TWCCarlson/MicroMouse/MAZE/ASSEM-EXAMPLE.SLDASM

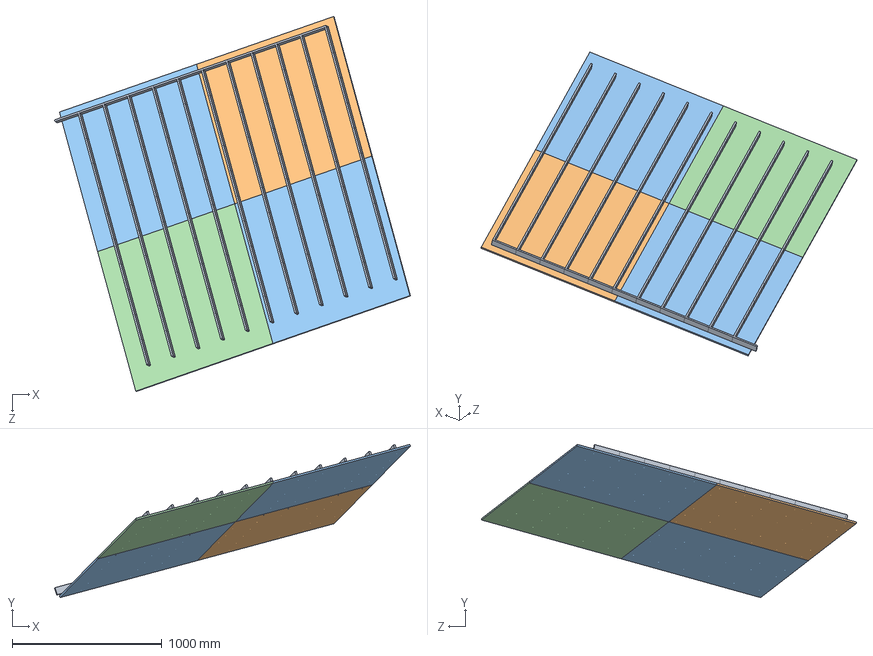
[picture p1: CAD file, 2020-10-15]
MAZE/ASSEM-EXAMPLE.SLDASM
2376.5 x 1023.0 x 2503.2 mm
WALL x 121
BASE-TYPE-A
BASE-TYPE-B x 2
BASE-TYPE-C
