TWCCarlson/MicroMouse/MOUSE/Assem3.SLDASM

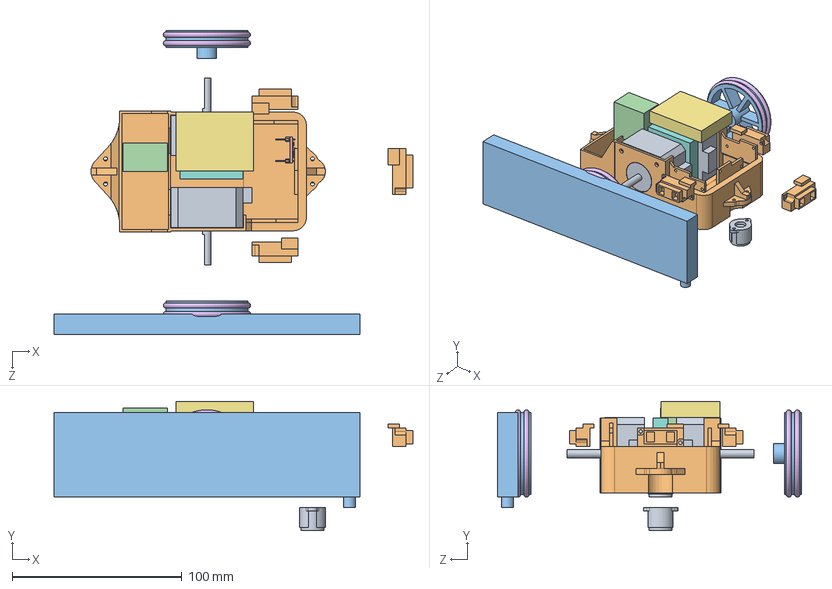
[picture p2: CAD file, 2020-12-29]
MOUSE/Assem3.SLDASM
211.3 x 76.0 x 179.0 mm
NEMA17 x 2
SharpIRSensor x 3
WheelRim2 x 2
O-rin x 4
LiPoBattery
BallCaster x 2
Chassis2
