TWCCarlson/MicroMouse/MOUSE/Assem2.SLDASM

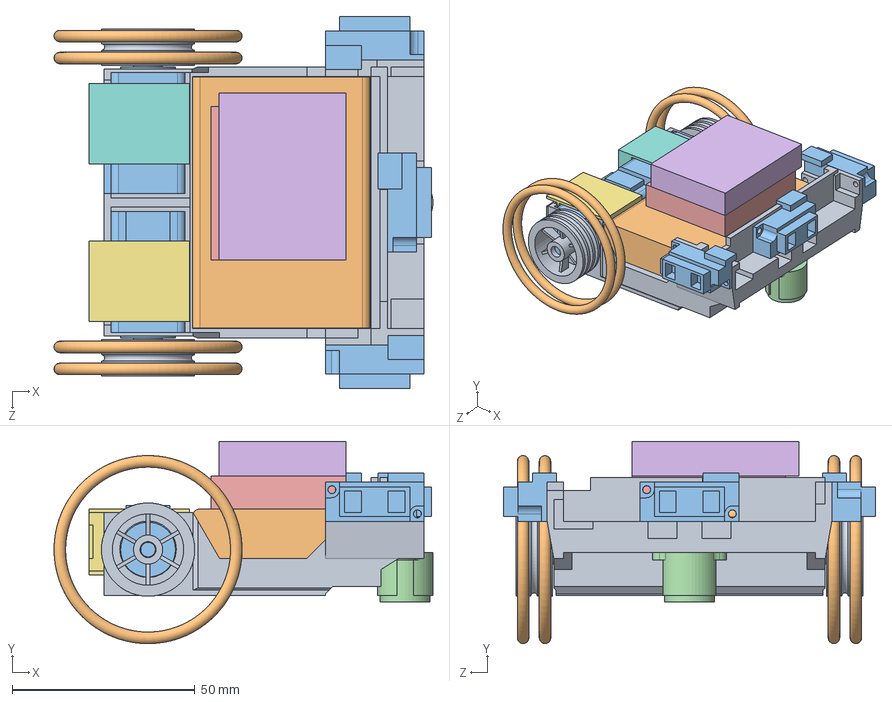
[picture p3: CAD file, 2020-11-01]
MOUSE/Assem2.SLDASM
103.6 x 55.3 x 101.8 mm
ChassisRemake
AABatteryPack
N8StepperMotor x 2
BallCaster
LiPoBattery
FeatherMiniBoard
N8DriverShelf
N8DriverShelfMir
WheelRim x 2
O-rin x 4
SharpIRSensor x 3
