TWCCarlson/MicroMouse/MOUSE/Assem1.SLDASM

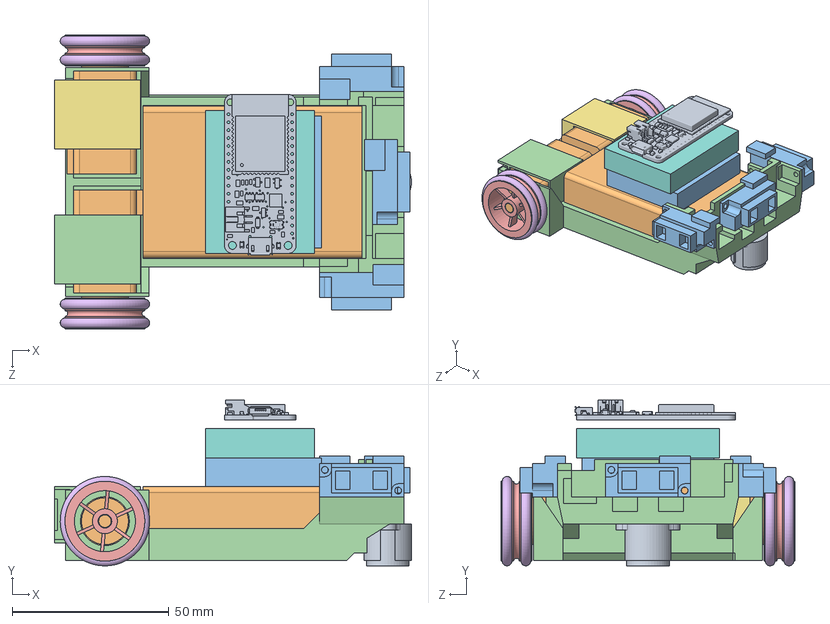
[picture p4: CAD file, 2020-10-16]
MOUSE/Assem1.SLDASM
114.0 x 53.0 x 94.0 mm
BallCaster
N8StepperMotor x 2
SharpIRSensor x 3
N8DriverShelf
WheelRim x 2
O-rin x 4
N8DriverShelfMir
FeatherMiniBoard
3405 Adafruit HUZZAH32 ESP32 Feather2
AABatteryPack
LiPoBattery
ChassisBreak
