TWCCarlson/MicroMouse/MOUSE/Calibration/IRCalibStand.SLDPRT

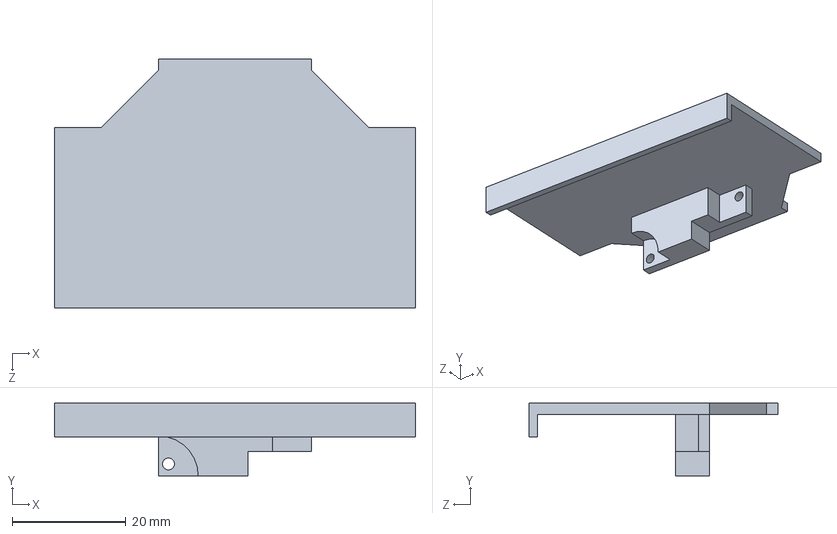
[picture p5: CAD file, 2020-11-25]
MOUSE/Calibration/IRCalibStand.SLDPRT
63.5 x 12.8 x 43.8 mm
