TWCCarlson/MicroMouse/MOUSE/Chassis2.sldprt

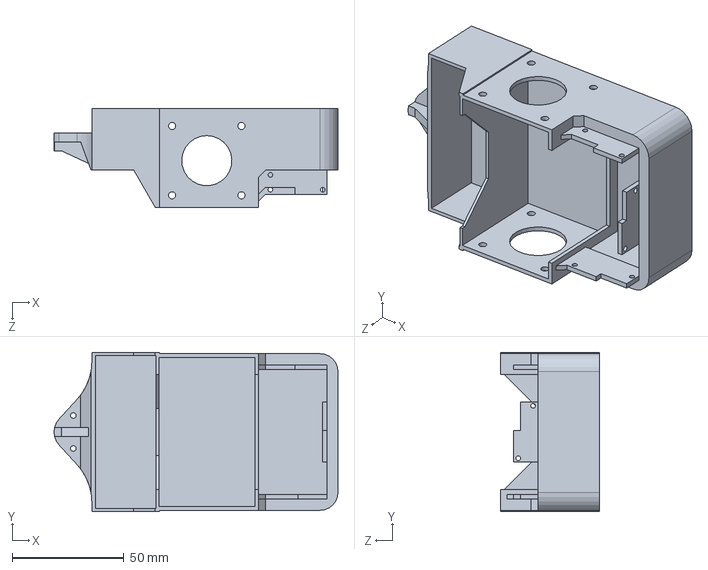
[picture p6: CAD file, 2020-12-29]
MOUSE/Chassis2.sldprt
126.9 x 71.2 x 44.1 mm
