TWCCarlson/MicroMouse/MAZE/BASE-TYPE-B.SLDPRT

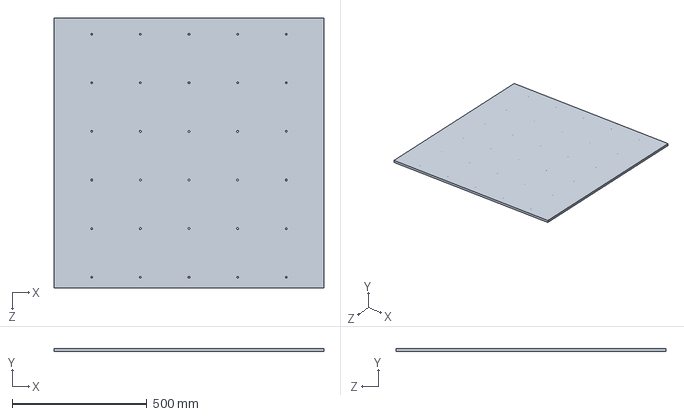
[picture p7: CAD file, 2020-10-15]
MAZE/BASE-TYPE-B.SLDPRT
1000.0 x 12.0 x 1000.0 mm
