TWCCarlson/MicroMouse/MOUSE/IRSensorVertMount.SLDPRT

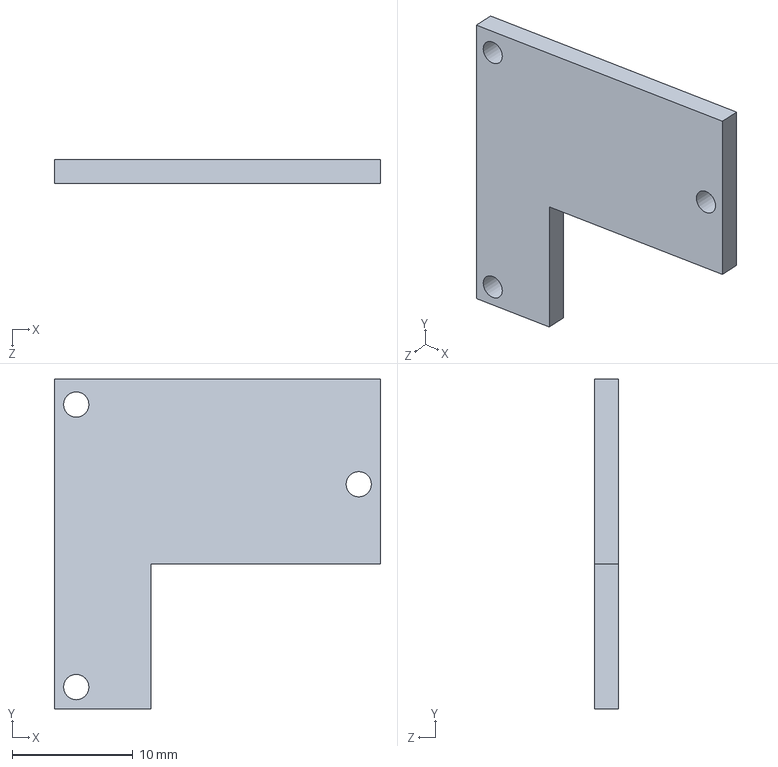
[picture p8: CAD file, 2020-12-11]
MOUSE/IRSensorVertMount.SLDPRT
27.0 x 27.3 x 2.00 mm
