TWCCarlson/MicroMouse/MAZE/WALL.SLDPRT

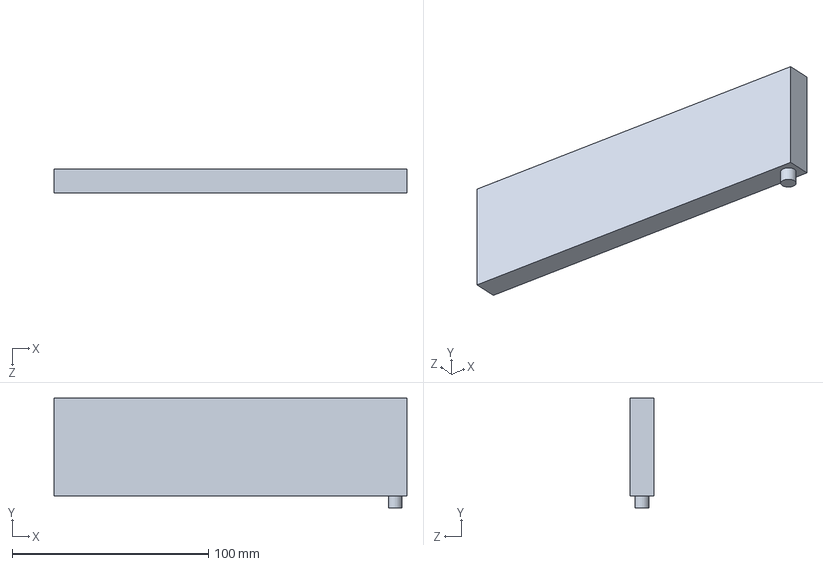
[picture p9: CAD file, 2020-10-15]
MAZE/WALL.SLDPRT
180.0 x 56.0 x 12.0 mm
