TWCCarlson/MicroMouse/MOUSE/IRSensorVertMountRight.SLDPRT

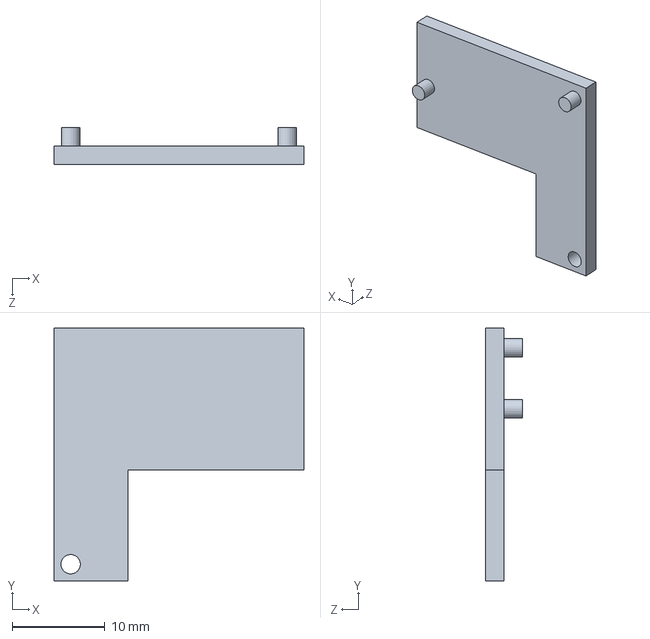
[picture p10: CAD file, 2020-12-11]
MOUSE/IRSensorVertMountRight.SLDPRT
27.0 x 27.3 x 4.00 mm
