TWCCarlson/MicroMouse/MOUSE/IRSensorVertMountLeft.SLDPRT

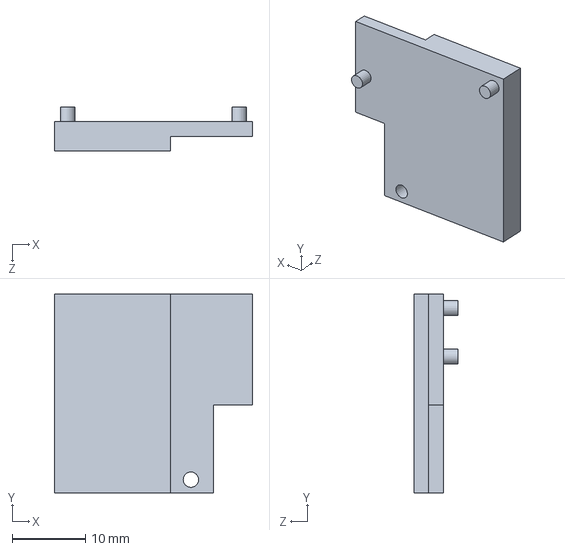
[picture p11: CAD file, 2020-12-11]
MOUSE/IRSensorVertMountLeft.SLDPRT
27.0 x 27.1 x 6.00 mm
