TWCCarlson/MicroMouse/MOUSE/WheelRim2.SLDPRT

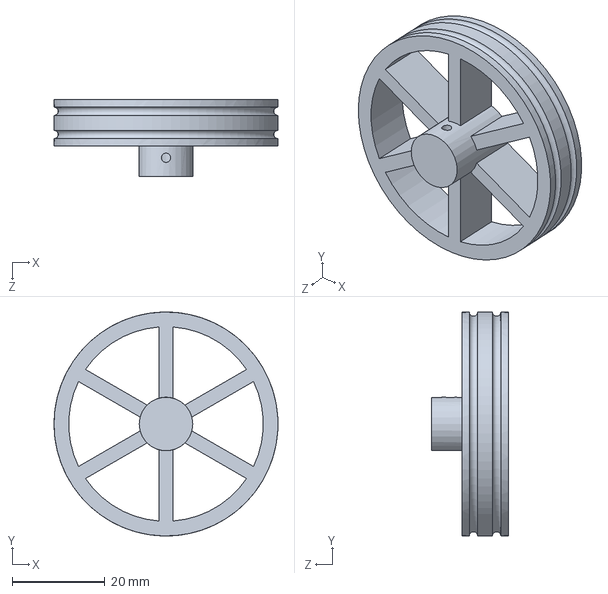
[picture p12: CAD file, 2020-11-30]
MOUSE/WheelRim2.SLDPRT
48.3 x 48.2 x 16.5 mm
