TWCCarlson/MicroMouse/MOUSE/N8DriverShelf1.SLDPRT

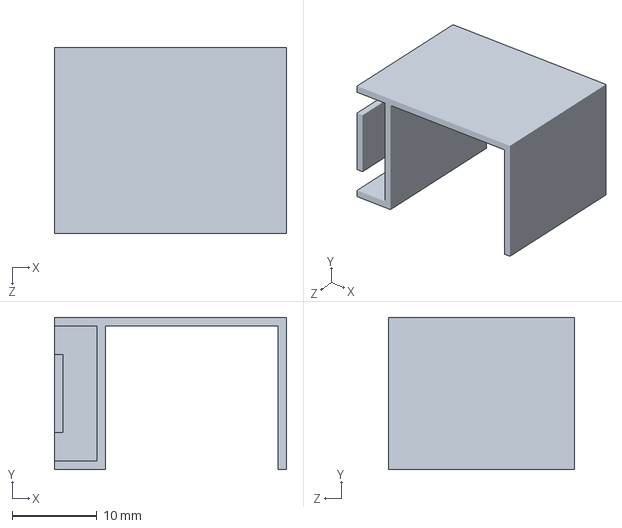
[picture p13: CAD file, 2020-11-01]
MOUSE/N8DriverShelf1.SLDPRT
27.4 x 18.0 x 22.0 mm
