TWCCarlson/MicroMouse/MOUSE/WheelRim.SLDPRT

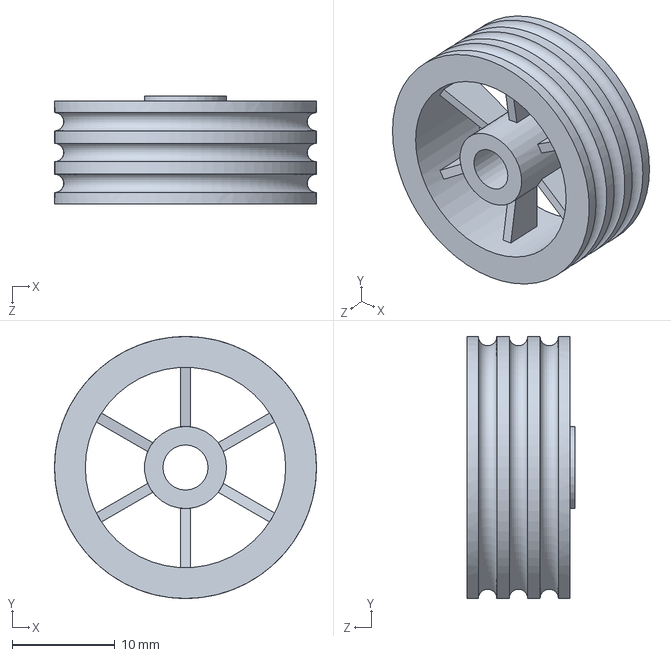
[picture p14: CAD file, 2020-11-01]
MOUSE/WheelRim.SLDPRT
25.5 x 25.5 x 10.5 mm
