TWCCarlson/MicroMouse/MOUSE/9vBattery.SLDPRT

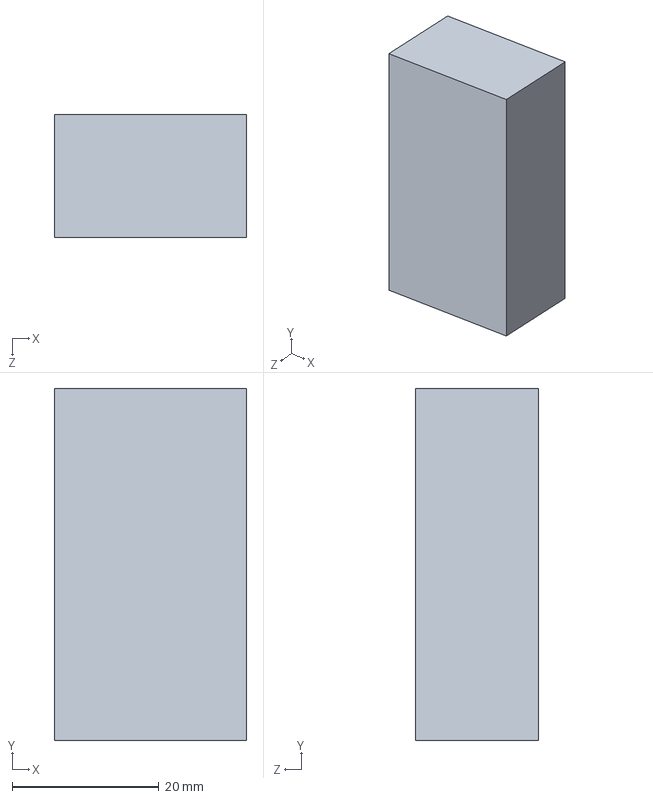
[picture p15: CAD file, 2020-11-01]
MOUSE/9vBattery.SLDPRT
26.2 x 48.0 x 16.8 mm
