TWCCarlson/MicroMouse/MOUSE/O-rin.SLDPRT

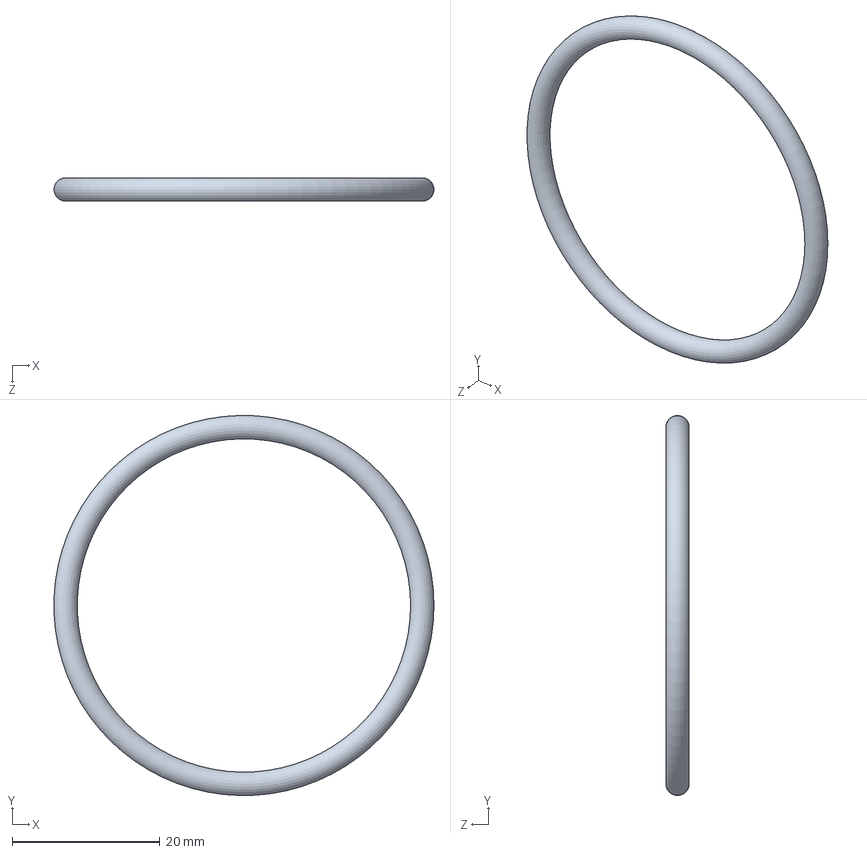
[picture p16: CAD file, 2020-11-01]
MOUSE/O-rin.SLDPRT
51.4 x 51.4 x 3.17 mm
