TWCCarlson/MicroMouse/MOUSE/NEMA17.SLDPRT

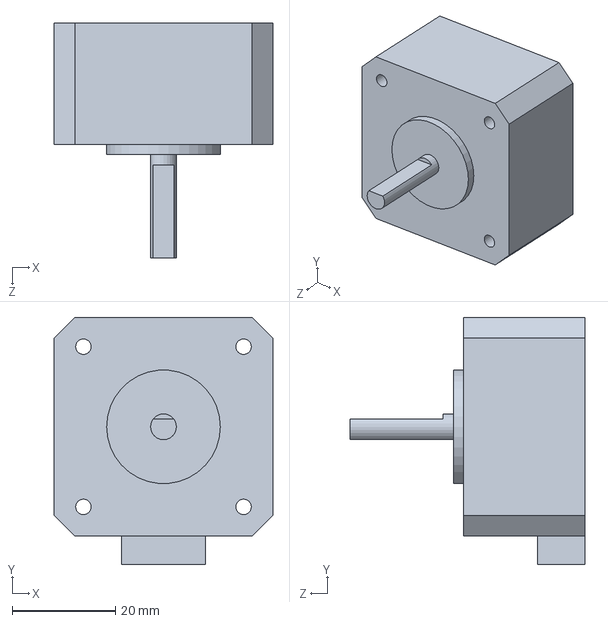
[picture p17: CAD file, 2020-11-01]
MOUSE/NEMA17.SLDPRT
42.3 x 47.8 x 45.5 mm
