TWCCarlson/MicroMouse/MOUSE/AABatteryPack.SLDPRT

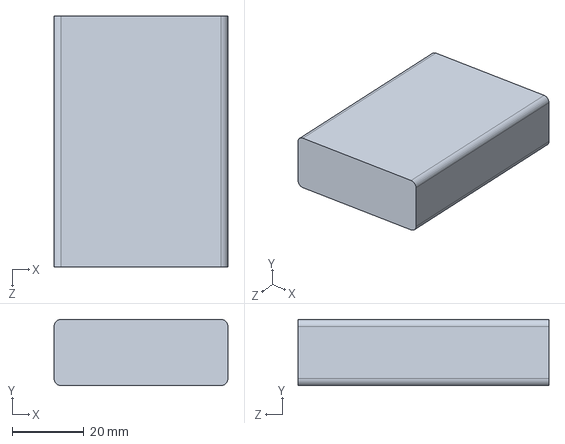
[picture p18: CAD file, 2020-10-16]
MOUSE/AABatteryPack.SLDPRT
48.5 x 18.5 x 70.0 mm
