TWCCarlson/MicroMouse/MOUSE/Chassis.SLDPRT

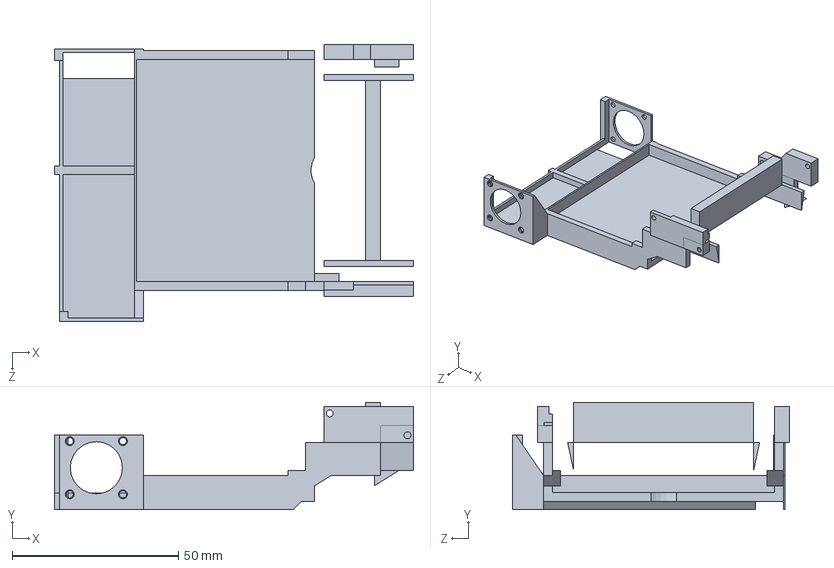
[picture p19: CAD file, 2020-10-16]
MOUSE/Chassis.SLDPRT
108.0 x 32.3 x 83.4 mm
