TWCCarlson/MicroMouse/MOUSE/ChassisRemake.SLDPRT

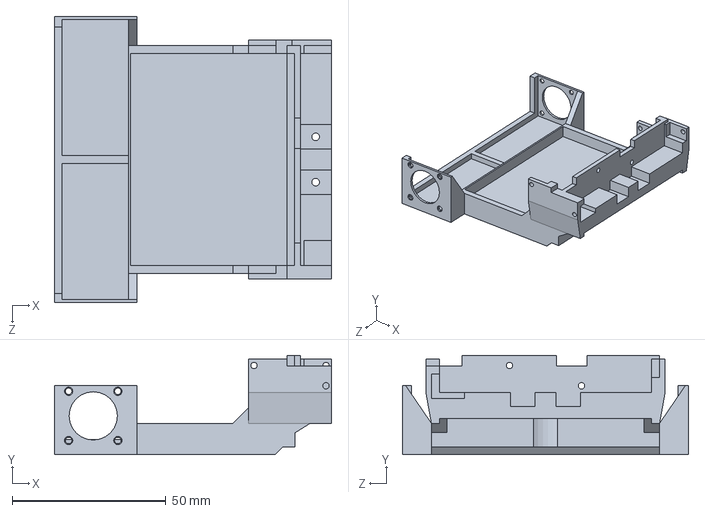
[picture p20: CAD file, 2020-10-16]
MOUSE/ChassisRemake.SLDPRT
90.1 x 32.3 x 93.0 mm
