TWCCarlson/MicroMouse/MOUSE/ChassisBreak.SLDPRT

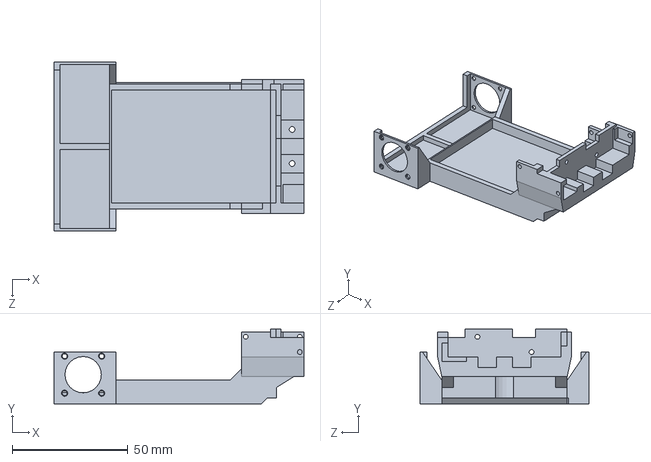
[picture p21: CAD file, 2020-10-16]
MOUSE/ChassisBreak.SLDPRT
108.0 x 32.3 x 73.0 mm
