TWCCarlson/MicroMouse/MOUSE/3405 Adafruit HUZZAH32 ESP32 Feather2.SLDPRT

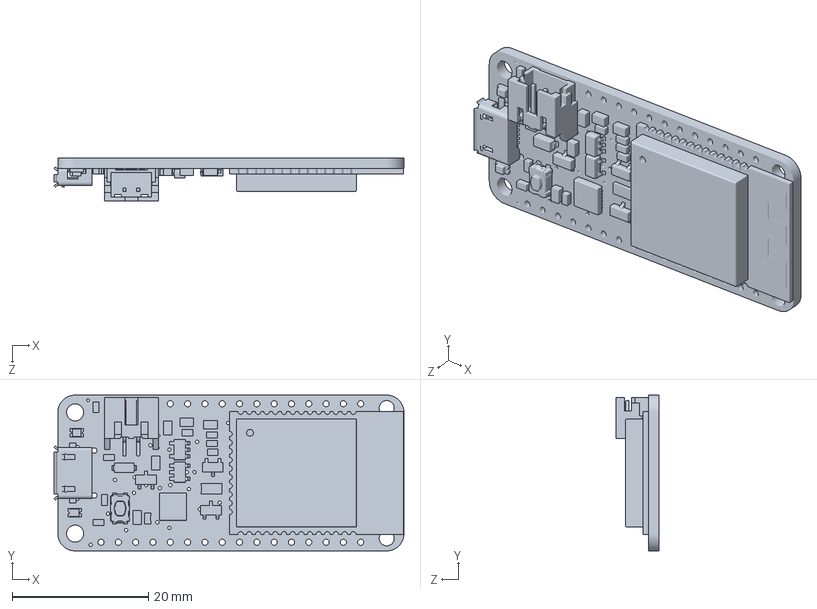
[picture p22: CAD file, 2020-10-15]
MOUSE/3405 Adafruit HUZZAH32 ESP32 Feather2.SLDPRT
51.4 x 22.9 x 6.37 mm
