TWCCarlson/MicroMouse/MOUSE/BallCaster.SLDPRT

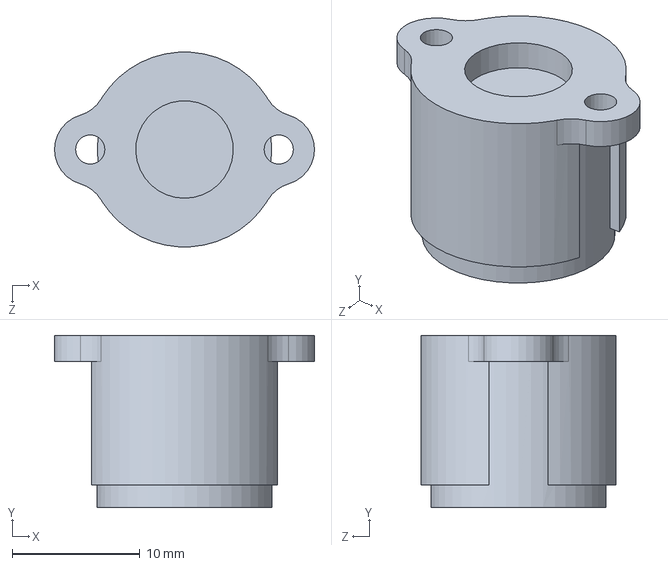
[picture p23: CAD file, 2020-10-15]
MOUSE/BallCaster.SLDPRT
20.3 x 13.5 x 15.2 mm
