TWCCarlson/MicroMouse/MOUSE/FeatherMiniBoard.SLDPRT

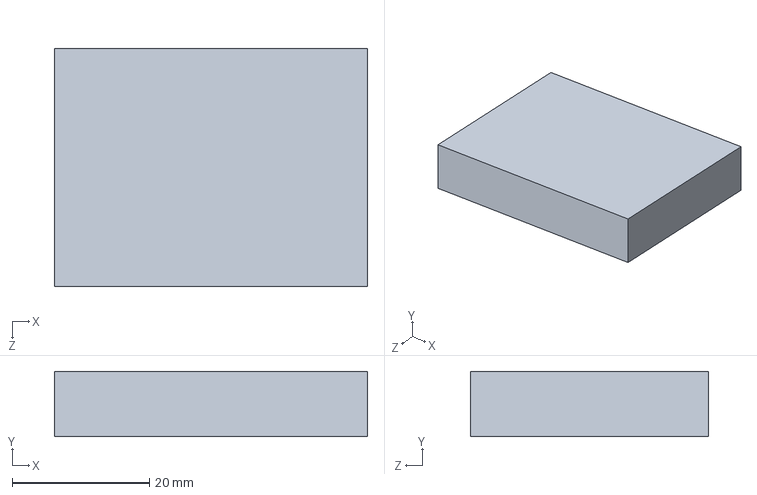
[picture p24: CAD file, 2020-10-15]
MOUSE/FeatherMiniBoard.SLDPRT
45.6 x 9.50 x 34.7 mm
