TWCCarlson/MicroMouse/MOUSE/N8StepperMotor.SLDPRT

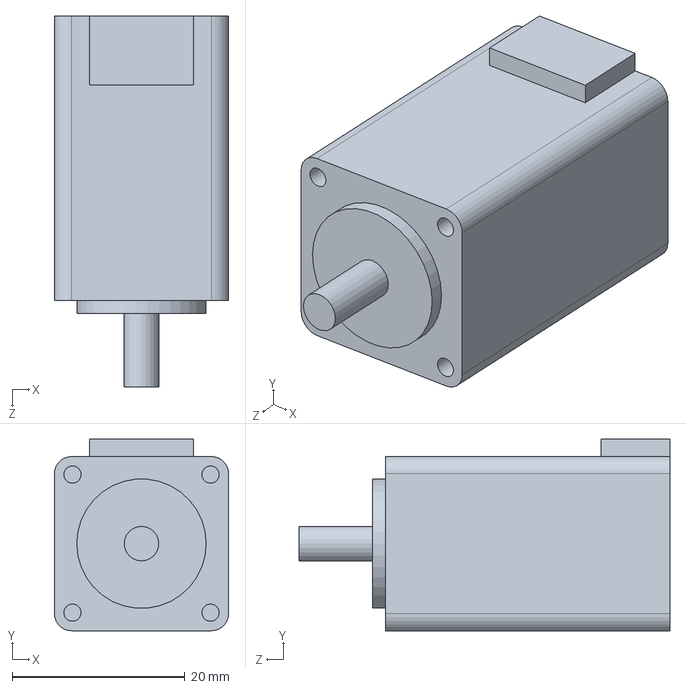
[picture p25: CAD file, 2020-10-15]
MOUSE/N8StepperMotor.SLDPRT
20.2 x 22.2 x 43.0 mm
