TWCCarlson/MicroMouse/MOUSE/SharpIRSensor.SLDPRT

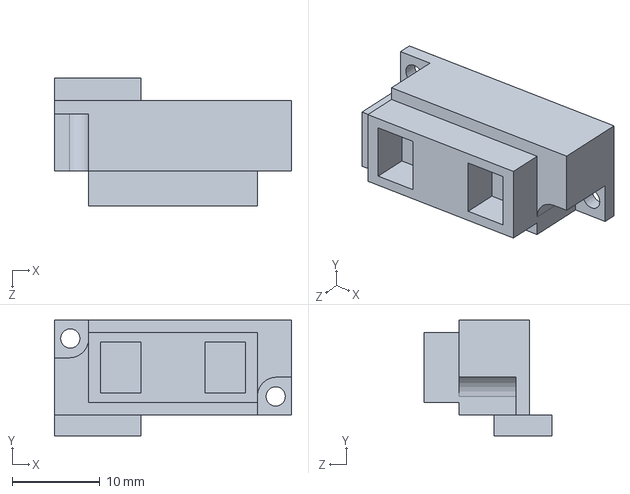
[picture p26: CAD file, 2020-10-15]
MOUSE/SharpIRSensor.SLDPRT
27.0 x 13.2 x 14.6 mm
