TWCCarlson/MicroMouse/MOUSE/LiPoBattery.SLDPRT

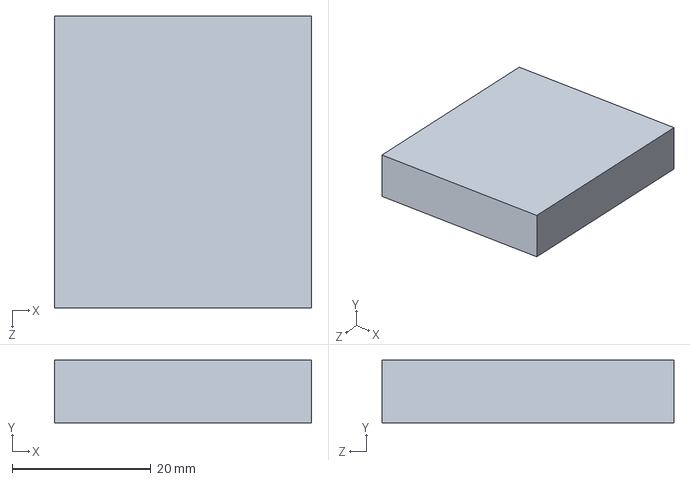
[picture p27: CAD file, 2020-10-15]
MOUSE/LiPoBattery.SLDPRT
37.0 x 9.00 x 42.0 mm
