TWCCarlson/MicroMouse/(list of files, cad)

Other CAD files:
MAZE/BASE-TYPE-A.SLDPRT
MAZE/BASE-TYPE-C.SLDPRT
MOUSE/N8DriverShelfMir.SLDPRT
MOUSE/N8DriverShelf.SLDPRT
MOUSE/Calibration/STL/IRCalibStand.STL
MOUSE/STL/Chassis.STL
MOUSE/STL/Chassis2.STL
MOUSE/STL/ChassisRemake.STL
MOUSE/STL/IRSensorVertMountLeft.STL
MOUSE/STL/IRSensorVertMountRight.SLDPRT
MOUSE/STL/IRSensorVertMountRight.STL
MOUSE/STL/N8DriverShelf.STL
MOUSE/STL/N8DriverShelfMir.STL
MOUSE/STL/WheelRim.STL
MOUSE/STL/WheelRim2.STL
