TWCCarlson/MicroMouse/(threads)

Thread 1 (2020-10-15):

First CAD Revision Requirements

TWCCarlson, 2020-10-15:
NEMA 8 Motor axle/face obstructed.
NEMA 8 Motor face screw holes may be unnecessary, need to be teardropped if kept.
Castor screw holes need to be oversized. Required diam 2mm, first print yielded 1.7mm.
Front SHARP IR Sensor screw holes need to be teardropped, but are usable and stable on first use. May become too loose later without nut.
Front SHARP IR Sensor backing wall needs to be thinned to use nuts, at least 1mm.
Front SHARP IR Sensor needs to be raised, 4mm.
Right SHARP IR Sensor screw holes need to be teardropped, but are usable and stable on first use. May become too loose later without nut.
Right SHARP IR Sensor backing wall needs to be thinned to use nuts, at least 1mm.
Right SHARP IR Sensor JST-side screw slot needs to be raised to use a nut, at least 2mm.
Left SHARP IR Sensor screw holes need to be teardropped, but are usable and stable on first use. May become too loose later without nut.
Left SHARP IR Sensor non JST-side screw slot needs to be lowered to use a nut, at least 2mm.
Left SHARP IR Sensor JST-side screw slot needs to be lowered to use a nut, at least 2mm.
Battery tray wall slot can be dropped to save on space, maybe 5mm for wire clearance, then reduce battery tray size allotment.
Battery tray motor-side wall can be slimmed about the battery case to save space, perhaps eliminated.

NEMA 8 Motor tray sizes are perfect with driver shelves. No play in any direction.
Driver shelves are perfectly level with battery case.
All SHARP IR sensor mounting locations are good and stable.
Castor fits against groove nicely, need to install motors properly to check overall mouse slope.
Driver shelves fit perfectly.
Will need to consider breadboard for connecting all devices, mini Arduino breadboard may not have enough slots.

Spare files in branch.

TWCCarlson, 2020-10-16:
Did not thin Front SHARP IR Sensor wall.
Battery tray too tight in length.
NEMA 8 Motor divider needs to be lowered or deleted, distance should not change. Obstructs JST connectors.
Wheels should have a protrusion in the direction of the motor to space from screws, and stop wobbling.

Closed 2020-10-16.

Thread 2 (2020-10-16):

Second CAD Revision Requirements

TWCCarlson, 2020-10-16:
Did not thin Front SHARP IR Sensor wall.
Battery tray too tight in length.
NEMA 8 Motor divider needs to be lowered or deleted, distance should not change. Obstructs JST connectors.
Wheels should have a protrusion in the direction of the motor to space from screws, and stop wobbling.

TWCCarlson, 2020-10-17:
3rd CAD Revision complete.
Rotated AA battery pack, shortened overall length by 2cm.

Closed 2020-10-17.

Thread 3 (2020-10-17):

Third CAD Revision Requirements

TWCCarlson, 2020-10-17:
Almost perfect.
One of the Nema 8 Motors is slightly larger than the other, causing interference on the shelf. Motor tray should be lengthened by 0.2-0.3mm.

Closed 2022-10-22.
