TWCCarlson/MicroMouse/CODE/Networking_Test/Networking_Test.ino

#include <WiFi.h>

const char ssid[] = "laurinet";
const char pass[] = "1onegem99";
int status = WL_IDLE_STATUS;

void setup() {
  Serial.begin(115200);

  scanNetworks();
  connectToNetwork();

  Serial.println(WiFi.localIP());
  Serial.println(WiFi.macAddress());
  
  WiFi.disconnect(true);
  Serial.println(WiFi.localIP());
}

void loop() {
  
}

void scanNetworks() {
  int numberOfNetworks = WiFi.scanNetworks();
  Serial.print("No. of networks: ");
  Serial.println(numberOfNetworks);

  for (int i = 0; i < numberOfNetworks; i++) {
    Serial.print("Network name: ");
    Serial.println(WiFi.SSID(i));
 
    Serial.print("Signal strength: ");
    Serial.println(WiFi.RSSI(i));
 
    Serial.print("MAC address: ");
    Serial.println(WiFi.BSSIDstr(i));
 
    Serial.print("Encryption type: ");
    String encryptionTypeDescription = translateEncryptionType(WiFi.encryptionType(i));
    Serial.println(encryptionTypeDescription);
 
    Serial.println("-----------------------");
  }
}

String translateEncryptionType(wifi_auth_mode_t encryptionType) {
  switch (encryptionType) {
    case (WIFI_AUTH_OPEN):
      return "Open";
    case (WIFI_AUTH_WEP):
      return "WEP";
    case (WIFI_AUTH_WPA_PSK):
      return "WPA_PSK";
    case (WIFI_AUTH_WPA2_PSK):
      return "WPA2_PSK";
    case (WIFI_AUTH_WPA_WPA2_PSK):
      return "WPA_WPA2_PSK";
    case (WIFI_AUTH_WPA2_ENTERPRISE):
      return "WPA2_ENTERPRISE";
  }
}

void connectToNetwork() {
  WiFi.begin(ssid, pass);

  while (WiFi.status() != WL_CONNECTED) {
    delay(1000);
    Serial.println("Establishing connection to WiFi..");
  }

  Serial.println("Connected to network");
}
