TWCCarlson/MicroMouse/(commit log)

2020-10-15 Initial CAD
    [3405 Adafruit HUZZAH32 ESP32 Feather.SLDPRT, 3405 Adafruit HUZZAH32 ESP32 Feather.stl, 3405 Adafruit HUZZAH32 ESP32 Feather2.SLDPRT, AABatteryPack.SLDPRT, ASSEM-EXAMPLE.SLDASM, Assem1.SLDASM, BASE-TYPE-A.SLDPRT, BASE-TYPE-B.SLDPRT]
2020-10-15 File Restructure
    [3405 Adafruit HUZZAH32 ESP32 Feather.SLDPRT, 3405 Adafruit HUZZAH32 ESP32 Feather.stl, ASSEM-EXAMPLE.SLDASM, Assem1.SLDASM, Chassis.STL, FullsizeMMVer1.fzz, MZW37-30Tire.SLDPRT, N8DriverShelf.STL]
2020-10-15 Revised Chassis
    [Chassis.SLDPRT, Chassis.STL]
2020-10-16 Add Second AA Pack Orientation
    [AABatteryPack.SLDPRT, Assem1.SLDASM, Assem2.SLDASM, Chassis.SLDPRT, Chassis.STL, ChassisBreak.SLDPRT, ChassisRemake.SLDPRT, ChassisRemake.STL]
2020-10-23 3rd Revision, Server Practice
    [Assem2.SLDASM, N8DriverShelf.SLDPRT, N8DriverShelf.STL, N8DriverShelfMir.SLDPRT, N8DriverShelfMir.STL, WheelRim.SLDPRT, WheelRim.STL]
2020-11-01 Final Design
    [9vBattery.SLDPRT, Assem2.SLDASM, Assem3.SLDASM, Chassis2.STL, Chassis2.sldprt, N8DriverShelf1.SLDPRT, NEMA17.SLDPRT, O-rin.SLDPRT]
2020-11-25 Backlog of updates
    IR Calibration done
    Chassis updates
    Still needs cleaning up
    [Assem3.SLDASM, Chassis2.STL, Chassis2.sldprt, IRCalibStand.SLDPRT, IRCalibStand.STL, Sen_I.xlsx, Sen_II.xlsx, Sen_III.xlsx]
2020-11-30 Microstepping movement
    [WheelRim2.SLDPRT, WheelRim2.STL]
2020-12-11 GAMER MOBILE
    Version 1 platform. Crashless in long sequences of planned motion on a 5x5 maze board. YT: https://www.youtube.com/watch?v=GZiG9qhwBs0
    [Assem3.SLDASM, Chassis2.sldprt, IRSensorVertMount.SLDPRT, IRSensorVertMountLeft.SLDPRT, IRSensorVertMountLeft.STL, IRSensorVertMountRight.SLDPRT, IRSensorVertMountRight.STL, Sen_I.xlsx]
2020-12-11 Randomized wandering
    Rare collisions
    [v1-Programming.ino]
2020-12-11 Recentering implemented
    Don't overuse. Recentering on one wall seemed to increase fail rates overall for some reason.
    [v1-Programming.ino]
2020-12-12 First go at ESP32 Webserver
2020-12-29 End semester commit
    [Assem3.SLDASM, Chassis2.sldprt]
